picocomputer/schematic/rp6502.assembly/photo1.jpg

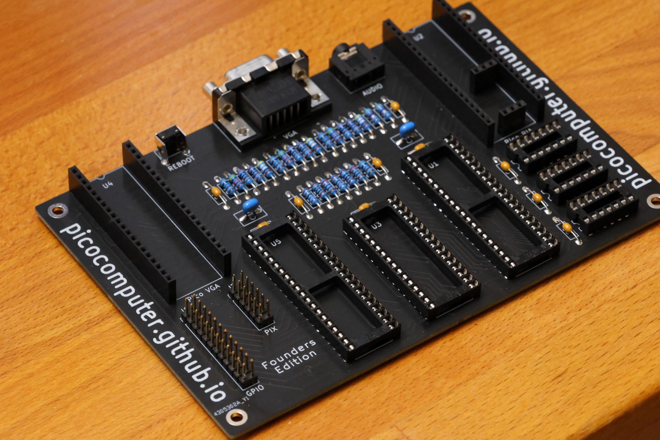
rp6502.assembly/photo1.jpg
