picocomputer/schematic/rp6502.assembly/photo2.jpg

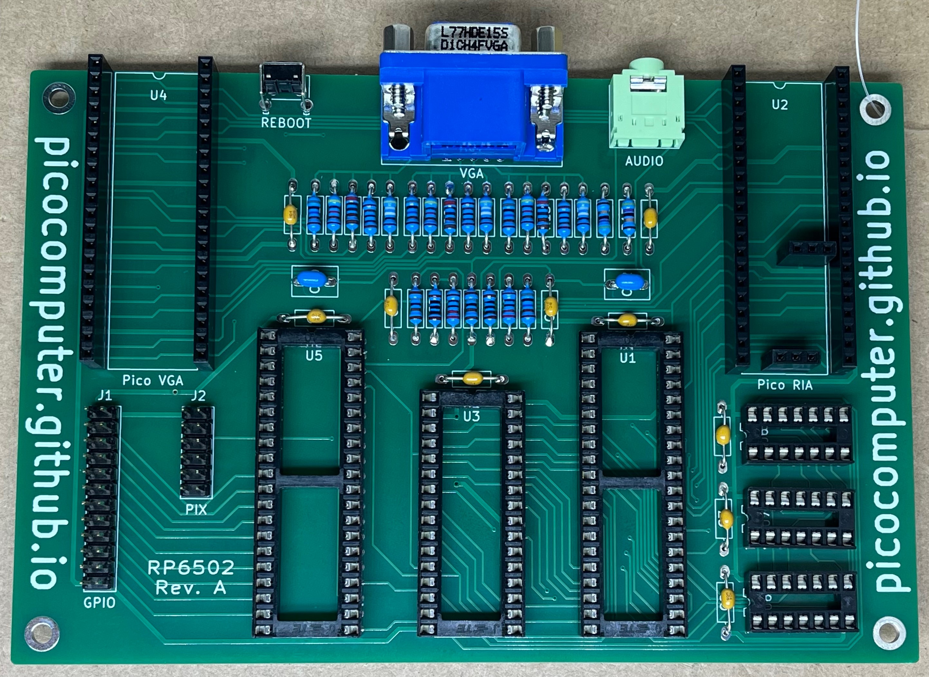
rp6502.assembly/photo2.jpg
