picocomputer/schematic/rp6502.acrylic/guide.stl

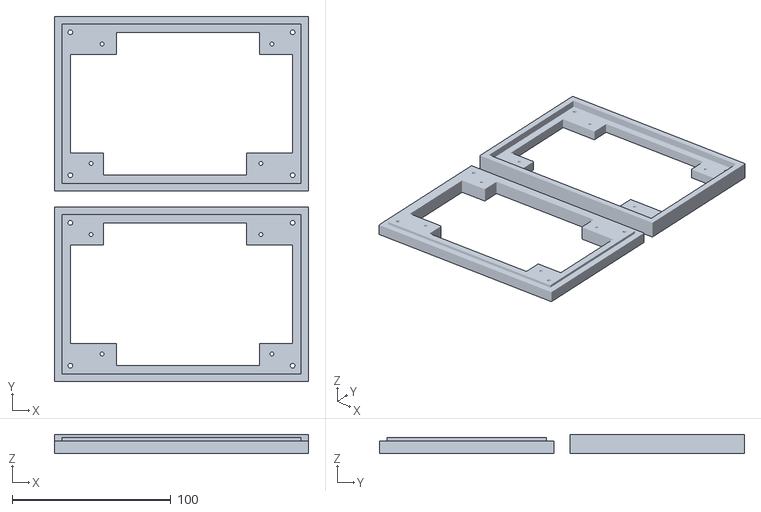
[picture p3: CAD file, 2025-11-14]
rp6502.acrylic/guide.stl
160.0 x 230.0 x 12.0
