picocomputer/schematic/rp6502.kicad_pcb

## KiCad design rp6502.kicad_pcb (2023-06-27)

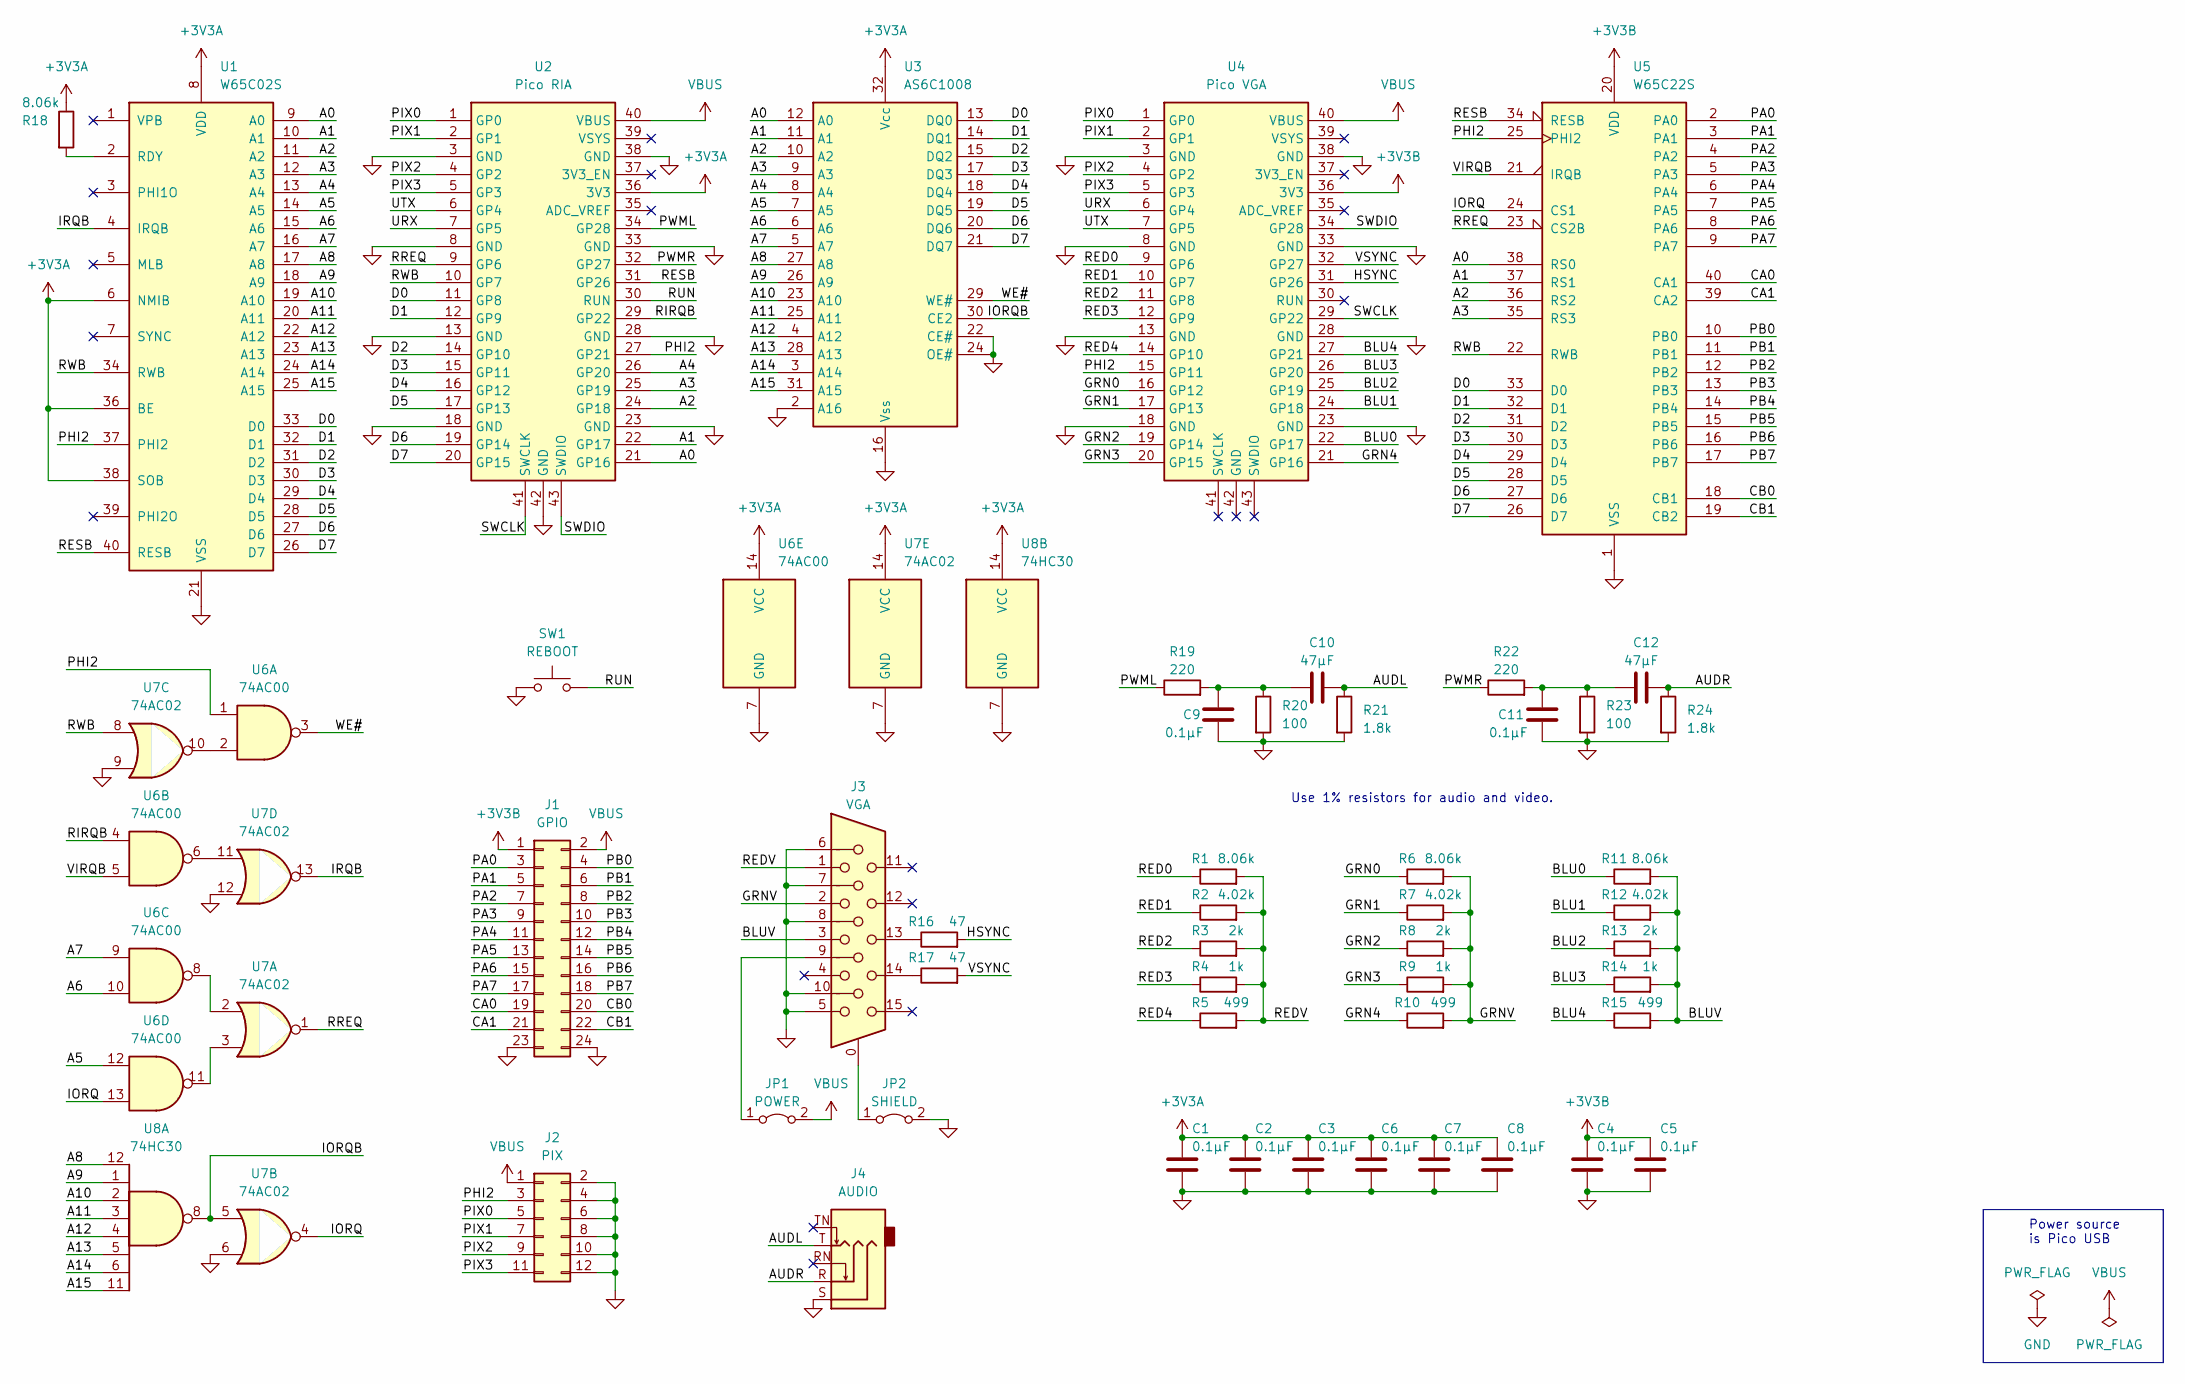
[picture p4: schematic rp6502.kicad_sch, The Picocomputer 6502 by Rumbledethumps]

Parts:
C1, C2, C3, C4, C5, C6, C7, C8, C9, C11: 0.1μF; R_Axial_DIN0207_L6.3mm_D2.5mm_P10.16mm_Horizontal_Long
C10, C12: 47μF; C_Disc_D7.5mm_W5.0mm_P5.00mm_Long
J1: GPIO; PinHeader_2x12_P2.54mm_Vertical
J2: PIX; PinHeader_2x06_P2.54mm_Vertical
J3: VGA; DSUB-15-HD_Female_Horizontal_P2.29x2.54mm_EdgePinOffset8.35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
J4: AUDIO; Jack_3.5mm_CUI_SJ1-3525N_Horizontal
JP1: POWER; SolderJumper-2_P1.3mm_Bridged2Bar_RoundedPad1.0x1.5mm
JP2: SHIELD; SolderJumper-2_P1.3mm_Bridged2Bar_RoundedPad1.0x1.5mm
R1, R6, R11, R18: 8.06k; R_Axial_DIN0207_L6.3mm_D2.5mm_P10.16mm_Horizontal_Long
R2, R7, R12: 4.02k; R_Axial_DIN0207_L6.3mm_D2.5mm_P10.16mm_Horizontal_Long
R3, R8, R13: 2k; R_Axial_DIN0207_L6.3mm_D2.5mm_P10.16mm_Horizontal_Long
R4, R9, R14: 1k; R_Axial_DIN0207_L6.3mm_D2.5mm_P10.16mm_Horizontal_Long
R5, R10, R15: 499; R_Axial_DIN0207_L6.3mm_D2.5mm_P10.16mm_Horizontal_Long
R16, R17: 47; R_Axial_DIN0207_L6.3mm_D2.5mm_P10.16mm_Horizontal_Long
R19, R22: 220; R_Axial_DIN0207_L6.3mm_D2.5mm_P10.16mm_Horizontal_Long
R20, R23: 100; R_Axial_DIN0207_L6.3mm_D2.5mm_P10.16mm_Horizontal_Long
R21, R24: 1.8k; R_Axial_DIN0207_L6.3mm_D2.5mm_P10.16mm_Horizontal_Long
SW1: REBOOT; SW_Tactile_SKHH_Angled
U1: W65C02S; DIP-40_W15.24mm_LongPads
U2: Pico RIA; DIP-40_W17.78mm_LongPads_PicoDebug
U3: AS6C1008; DIP-32_W15.24mm_LongPads
U4: Pico VGA; DIP-40_W17.78mm_LongPads
U5: W65C22S; DIP-40_W15.24mm_LongPads
U6: 74AC00; DIP-14_W7.62mm_LongPads
U7: 74AC02; DIP-14_W7.62mm_LongPads
U8: 74HC30; DIP-14_W7.62mm_LongPads

Connections:
+3V3A: C1.1, C2.1, C3.1, C6.1, C7.1, C8.1, R18.1, U1.6 (NMIB), U1.8 (VDD), U1.36 (BE), U1.38 (SOB), U2.36 (3V3), U3.32 (Vcc), U6.14 (VCC), U7.14 (VCC), U8.14 (VCC)
+3V3B: C4.1, C5.1, J1.1, U4.36 (3V3), U5.20 (VDD)
/A0: U1.9 (A0), U2.21 (GP16), U3.12 (A0), U5.38 (RS0)
/A1: U1.10 (A1), U2.22 (GP17), U3.11 (A1), U5.37 (RS1)
/A2: U1.11 (A2), U2.24 (GP18), U3.10 (A2), U5.36 (RS2)
/A3: U1.12 (A3), U2.25 (GP19), U3.9 (A3), U5.35 (RS3)
/A4: U1.13 (A4), U2.26 (GP20), U3.8 (A4)
/A5: U1.14 (A5), U3.7 (A5), U6.12
/A6: U1.15 (A6), U3.6 (A6), U6.10
/A7: U1.16 (A7), U3.5 (A7), U6.9
/A8: U1.17 (A8), U3.27 (A8), U8.12
/A9: U1.18 (A9), U3.26 (A9), U8.1
/A10: U1.19 (A10), U3.23 (A10), U8.2
/A11: U1.20 (A11), U3.25 (A11), U8.3
/A12: U1.22 (A12), U3.4 (A12), U8.4
/A13: U1.23 (A13), U3.28 (A13), U8.5
/A14: U1.24 (A14), U3.3 (A14), U8.6
/A15: U1.25 (A15), U3.31 (A15), U8.11
/AUDL: C10.2, J4.T, R21.1
/AUDR: C12.2, J4.R, R24.1
/BLU0: R11.1, U4.22 (GP17)
/BLU1: R12.1, U4.24 (GP18)
/BLU2: R13.1, U4.25 (GP19)
/BLU3: R14.1, U4.26 (GP20)
/BLU4: R15.1, U4.27 (GP21)
/BLUV: J3.3, R11.2, R12.2, R13.2, R14.2, R15.2
/CA0: J1.19, U5.40 (CA1)
/CA1: J1.21, U5.39 (CA2)
/CB0: J1.20, U5.18 (CB1)
/CB1: J1.22, U5.19 (CB2)
/D0: U1.33 (D0), U2.11 (GP8), U3.13 (DQ0), U5.33 (D0)
/D1: U1.32 (D1), U2.12 (GP9), U3.14 (DQ1), U5.32 (D1)
/D2: U1.31 (D2), U2.14 (GP10), U3.15 (DQ2), U5.31 (D2)
/D3: U1.30 (D3), U2.15 (GP11), U3.17 (DQ3), U5.30 (D3)
/D4: U1.29 (D4), U2.16 (GP12), U3.18 (DQ4), U5.29 (D4)
/D5: U1.28 (D5), U2.17 (GP13), U3.19 (DQ5), U5.28 (D5)
/D6: U1.27 (D6), U2.19 (GP14), U3.20 (DQ6), U5.27 (D6)
/D7: U1.26 (D7), U2.20 (GP15), U3.21 (DQ7), U5.26 (D7)
/GRN0: R6.1, U4.16 (GP12)
/GRN1: R7.1, U4.17 (GP13)
/GRN2: R8.1, U4.19 (GP14)
/GRN3: R9.1, U4.20 (GP15)
/GRN4: R10.1, U4.21 (GP16)
/GRNV: J3.2, R6.2, R7.2, R8.2, R9.2, R10.2
/HSYNC: R16.2, U4.31 (GP26)
/IORQ: U5.24 (CS1), U6.13, U7.4
/IORQB: U3.30 (CE2), U7.5, U8.8
/IRQB: U1.4 (IRQB), U7.13
/PA0: J1.3, U5.2 (PA0)
/PA1: J1.5, U5.3 (PA1)
/PA2: J1.7, U5.4 (PA2)
/PA3: J1.9, U5.5 (PA3)
/PA4: J1.11, U5.6 (PA4)
/PA5: J1.13, U5.7 (PA5)
/PA6: J1.15, U5.8 (PA6)
/PA7: J1.17, U5.9 (PA7)
/PB0: J1.4, U5.10 (PB0)
/PB1: J1.6, U5.11 (PB1)
/PB2: J1.8, U5.12 (PB2)
/PB3: J1.10, U5.13 (PB3)
/PB4: J1.12, U5.14 (PB4)
/PB5: J1.14, U5.15 (PB5)
/PB6: J1.16, U5.16 (PB6)
/PB7: J1.18, U5.17 (PB7)
/PHI2: J2.3, U1.37 (PHI2), U2.27 (GP21), U4.15 (GP11), U5.25 (PHI2), U6.1
/PIX0: J2.5, U2.1 (GP0), U4.1 (GP0)
/PIX1: J2.7, U2.2 (GP1), U4.2 (GP1)
/PIX2: J2.9, U2.4 (GP2), U4.4 (GP2)
/PIX3: J2.11, U2.5 (GP3), U4.5 (GP3)
/PWML: R19.1, U2.34 (GP28)
/PWMR: R22.1, U2.32 (GP27)
/RED0: R1.1, U4.9 (GP6)
/RED1: R2.1, U4.10 (GP7)
/RED2: R3.1, U4.11 (GP8)
/RED3: R4.1, U4.12 (GP9)
/RED4: R5.1, U4.14 (GP10)
/REDV: J3.1, R1.2, R2.2, R3.2, R4.2, R5.2
/RESB: U1.40 (RESB), U2.31 (GP26), U5.34 (RESB)
/RIRQB: U2.29 (GP22), U6.4
/RREQ: U2.9 (GP6), U5.23 (CS2B), U7.1
/RUN: SW1.2, U2.30 (RUN)
/RWB: U1.34 (RWB), U2.10 (GP7), U5.22 (RWB), U7.8
/SWCLK: U2.41 (SWCLK), U4.29 (GP22)
/SWDIO: U2.43 (SWDIO), U4.34 (GP28)
/URX: U2.7 (GP5), U4.6 (GP4)
/UTX: U2.6 (GP4), U4.7 (GP5)
/VIRQB: U5.21 (IRQB), U6.5
/VSYNC: R17.2, U4.32 (GP27)
/WE#: U3.29 (WE#), U6.3
GND: C1.2, C2.2, C3.2, C4.2, C5.2, C6.2, C7.2, C8.2, C9.2, C11.2, J1.23, J1.24, J2.2, J2.4, J2.6, J2.8, J2.10, J2.12, J3.5, J3.6, J3.7, J3.8, J3.10, J4.S, JP2.2 (B), R20.2, R21.2, R23.2, R24.2, SW1.1, U1.21 (VSS), U2.3 (GND), U2.8 (GND), U2.13 (GND), U2.18 (GND), U2.23 (GND), U2.28 (GND), U2.33 (GND), U2.38 (GND), U2.42 (GND), U3.2 (A16), U3.16 (Vss), U3.22 (CE#), U3.24 (OE#), U4.3 (GND), U4.8 (GND), U4.13 (GND), U4.18 (GND), U4.23 (GND), U4.28 (GND), U4.33 (GND), U4.38 (GND), U5.1 (VSS), U6.7 (GND), U7.6, U7.7 (GND), U7.9, U7.12, U8.7 (GND), U8.9 (NC)
unnamed: C9.1, C10.1, R19.2, R20.1
unnamed: C11.1, C12.1, R22.2, R23.1
unnamed: J3.13, R16.1
unnamed: J3.14, R17.1
unnamed: J3.9, JP1.1 (A)
unnamed: J3.0, JP2.1 (A)
unnamed: R18.2, U1.2 (RDY)
unnamed: U6.2, U7.10
unnamed: U6.6, U7.11
unnamed: U6.8, U7.2
unnamed: U6.11, U7.3
VBUS: J1.2, J2.1, JP1.2 (B), U2.40 (VBUS), U4.40 (VBUS)

Notes on the sheet:
Use 1% resistors for audio and video.
Power source is Pico USB

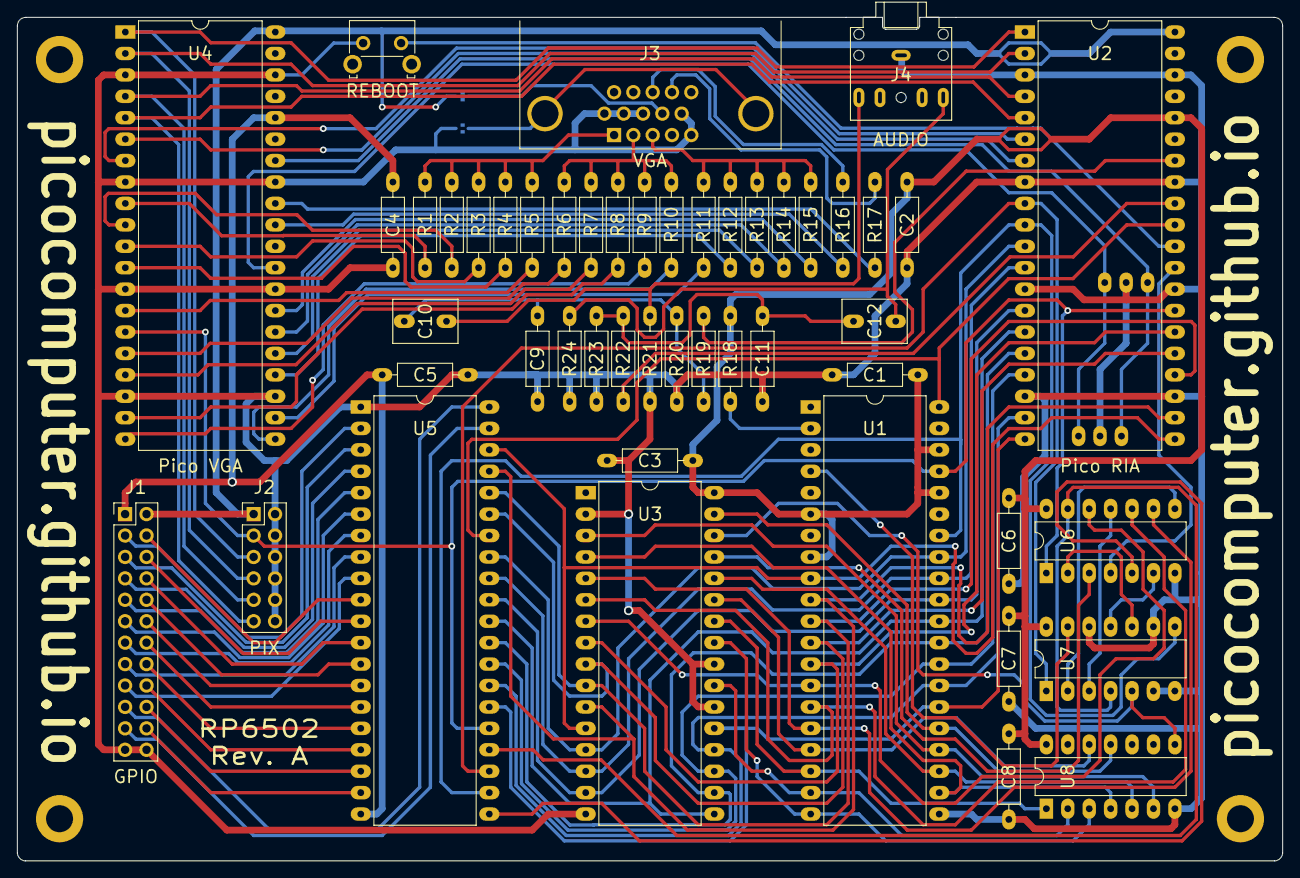
[picture p5: board rp6502.kicad_pcb from above]

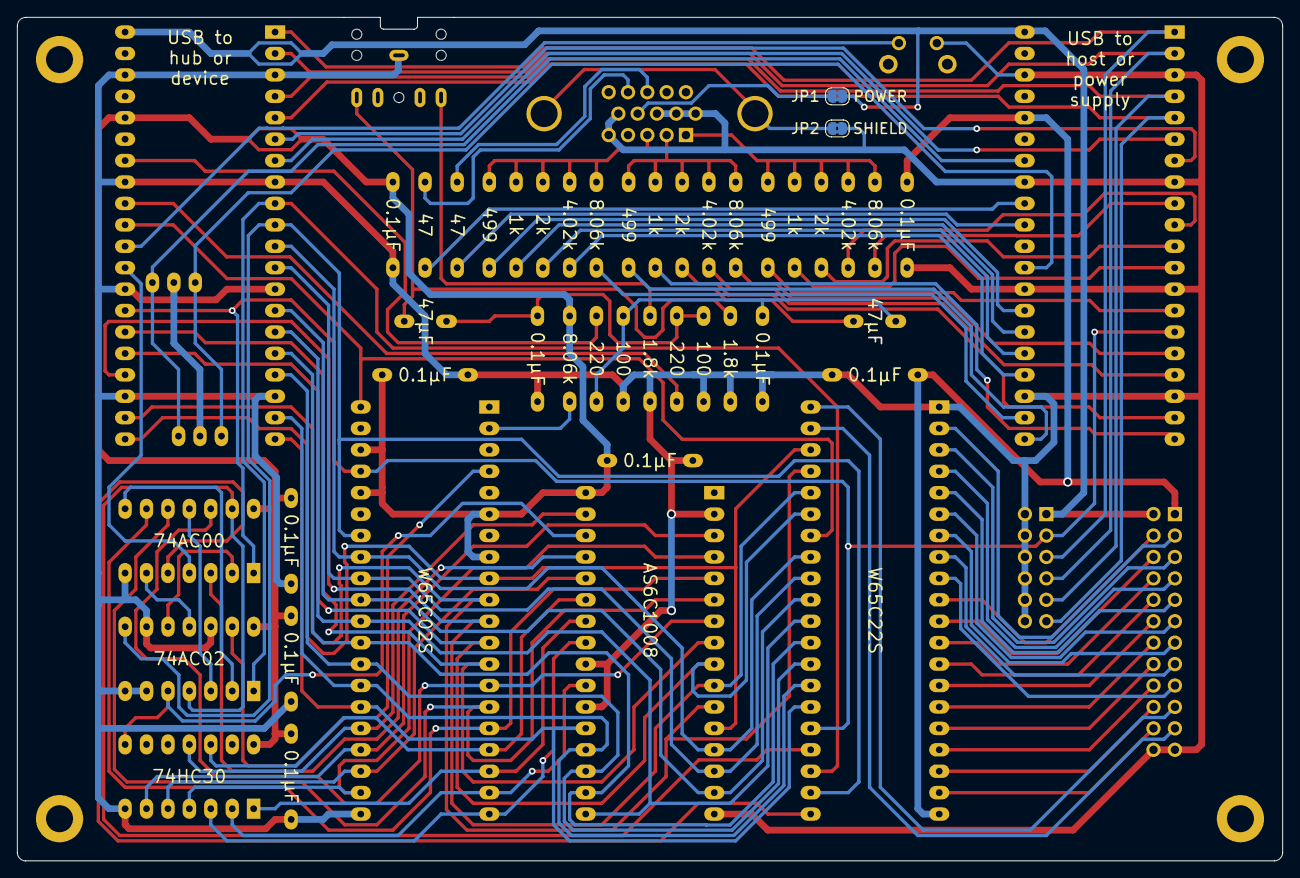
[picture p6: board rp6502.kicad_pcb from below]

Board: 2 copper layers, 150.0 x 100.0 mm, 51 parts (2 on the bottom side), 102 nets.
