picocomputer/schematic/(threads)

Thread 1 (2023-08-27):

Protect VIA ports with current limit resistors

rl000, 2023-08-27:
Hello,

W65C22S could be damage by short to the power rails and IO pins or between IO pins. Previous versions of the device have build in protection resistors, however W65C22S doesn't have protection (please see datasheet 5.5).

It will be nice to have protection resistors on PCB in serials with ports output and pin header with value about 180 Om.

Regards,
Roman

rumbledethumps, 2023-08-27:
The current limiting resistors were almost certainly removed because circuit designers asked for them to be removed. I'm not putting them back. This violates the principle of least surprise.

Closed 2023-08-27.
