picocomputer/schematic/(commit log)

2023-05-22 pcb beauty
    [rp6502.kicad_pcb]
2023-05-22 pcb complete
    [rp6502.kicad_pcb, rp6502.kicad_sch]
2023-05-23 founders edition
    [rp6502.kicad_pcb, rp6502.kicad_sch]
2023-06-08 update date
    [rp6502.kicad_sch]
2023-06-22 first assembly
    [bom.csv, rp6502.kicad_pcb, rp6502.kicad_sch]
2023-06-27 PTH slot increase for PCBWay
    [rp6502.kicad_pcb, rp6502.kicad_sch]
2023-06-30 add standoffs
    [standoffs.scad]
2023-06-30 update notes
    [bom.csv]
2023-07-20 update assembly docs
2025-11-10 add drill guide
    [guide.scad, guide.stl]
2025-11-14 fine tune acrylic
    [guide.scad, guide.stl]
